Magpie-81/lumenpnp/pnp/pcb/mobo/Mobo_Drawing.pdf

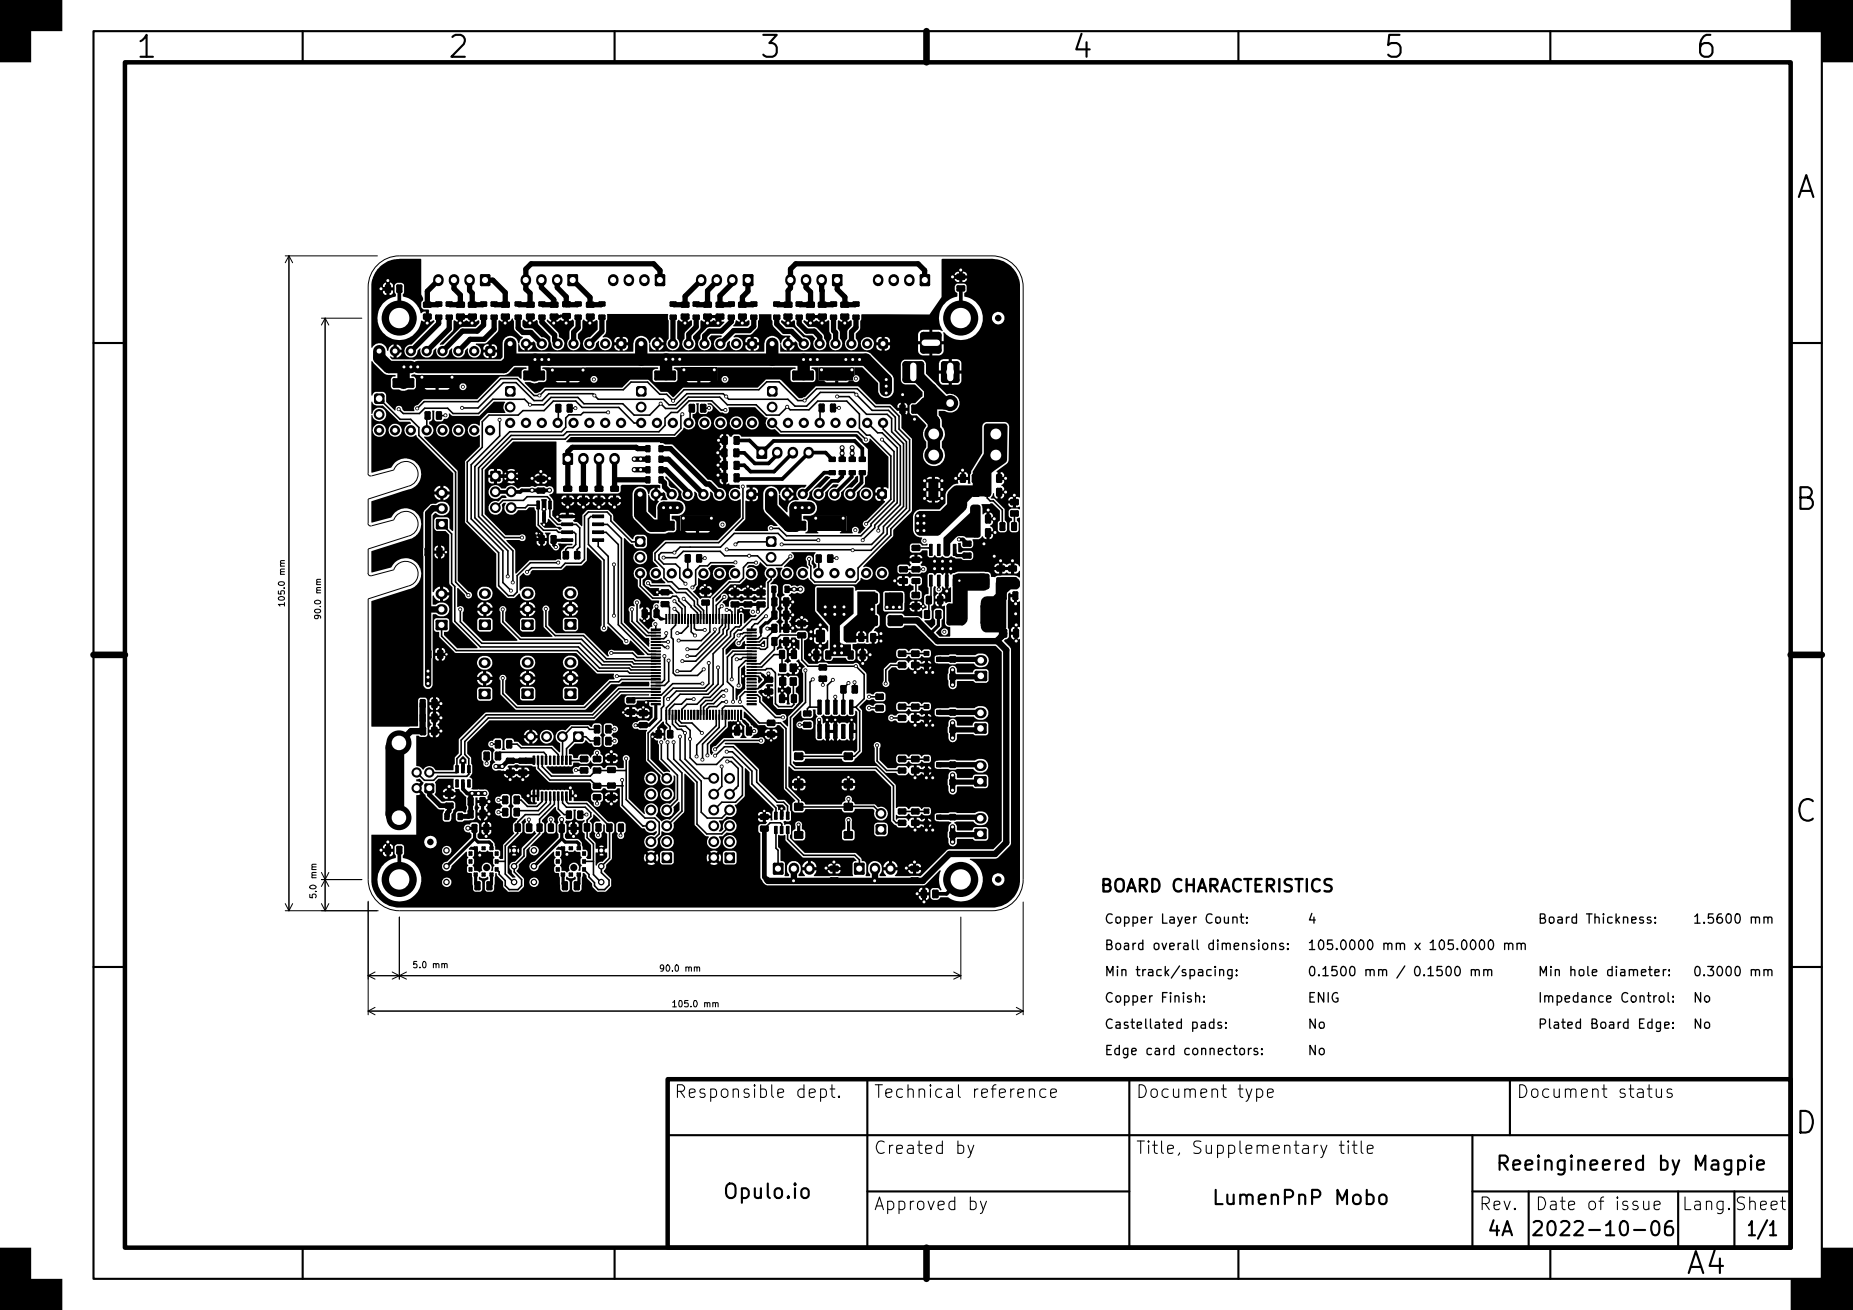
[picture p1: page 1]
