Magpie-81/lumenpnp/pnp/pcb/mobo/RS485.kicad_sch

## KiCad design pnp/pcb/mobo/RS485.kicad_sch (2022-10-09)

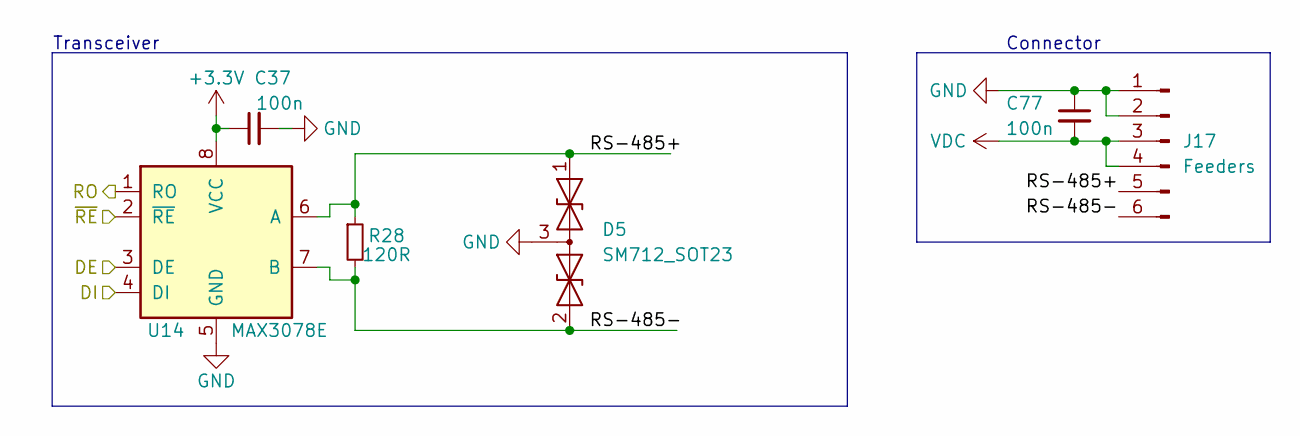
[picture p2: schematic RS485.kicad_sch]

Parts:
C37, C77: 100n; C_0805_2012Metric; Mouser 710-885012207098
D5: SM712_SOT23; SOT-23; Mouser 947-SM712.TCT
J17: Feeders; IDC-Header_2x03_P2.54mm_Vertical; Mouser 538-87834-0619
R28: 120R; R_0805_2012Metric; Mouser 755-SDR10EZPF1200
U14: MAX3078E; SOIC-8_3.9x4.9mm_P1.27mm; Mouser 700-MAX3078EESA

Connections:
+3.3V: C37.1, U14.8 (VCC)
DE: U14.3 (DE)
DI: U14.4 (DI)
GND: C37.2, C77.1, D5.3 (common), J17.1, J17.2, U14.5 (GND)
RO: U14.1 (RO)
RS-485+: D5.1 (A1), J17.5, R28.1, U14.6 (A)
RS-485-: D5.2 (A2), J17.6, R28.2, U14.7 (B)
VDC: C77.2, J17.3, J17.4
~RE: U14.2 (~RE)

Notes on the sheet:
Transceiver
Connector
