Magpie-81/lumenpnp/pnp/pcb/mobo/lighting.kicad_sch

## KiCad design pnp/pcb/mobo/lighting.kicad_sch (2022-10-09)

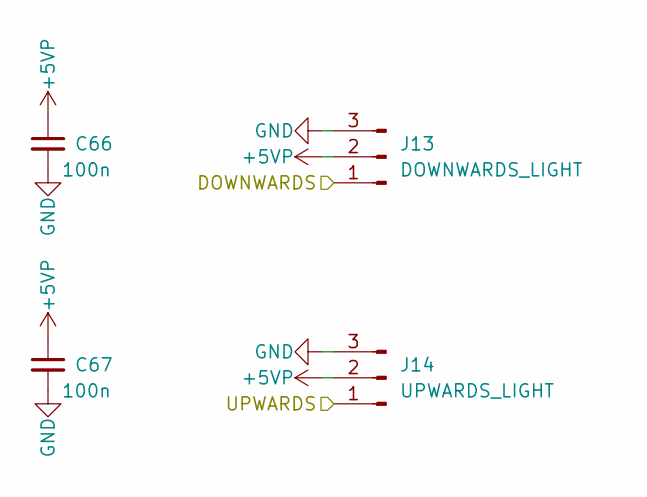
[picture p4: schematic lighting.kicad_sch]

Parts:
C66, C67: 100n; C_0805_2012Metric; Mouser 710-885012207098
J13: DOWNWARDS_LIGHT; JST_XH_B3B-XH-A_1x03_P2.50mm_Vertical; Digikey 455-2248-ND
J14: UPWARDS_LIGHT; JST_XH_B3B-XH-A_1x03_P2.50mm_Vertical; Digikey 455-2248-ND

Connections:
+5VP: C66.1, C67.1, J13.2, J14.2
DOWNWARDS: J13.1
GND: C66.2, C67.2, J13.3, J14.3
UPWARDS: J14.1
