Magpie-81/lumenpnp/pnp/pcb/mobo/microcontroller.kicad_sch

## KiCad design pnp/pcb/mobo/microcontroller.kicad_sch (2022-10-09)

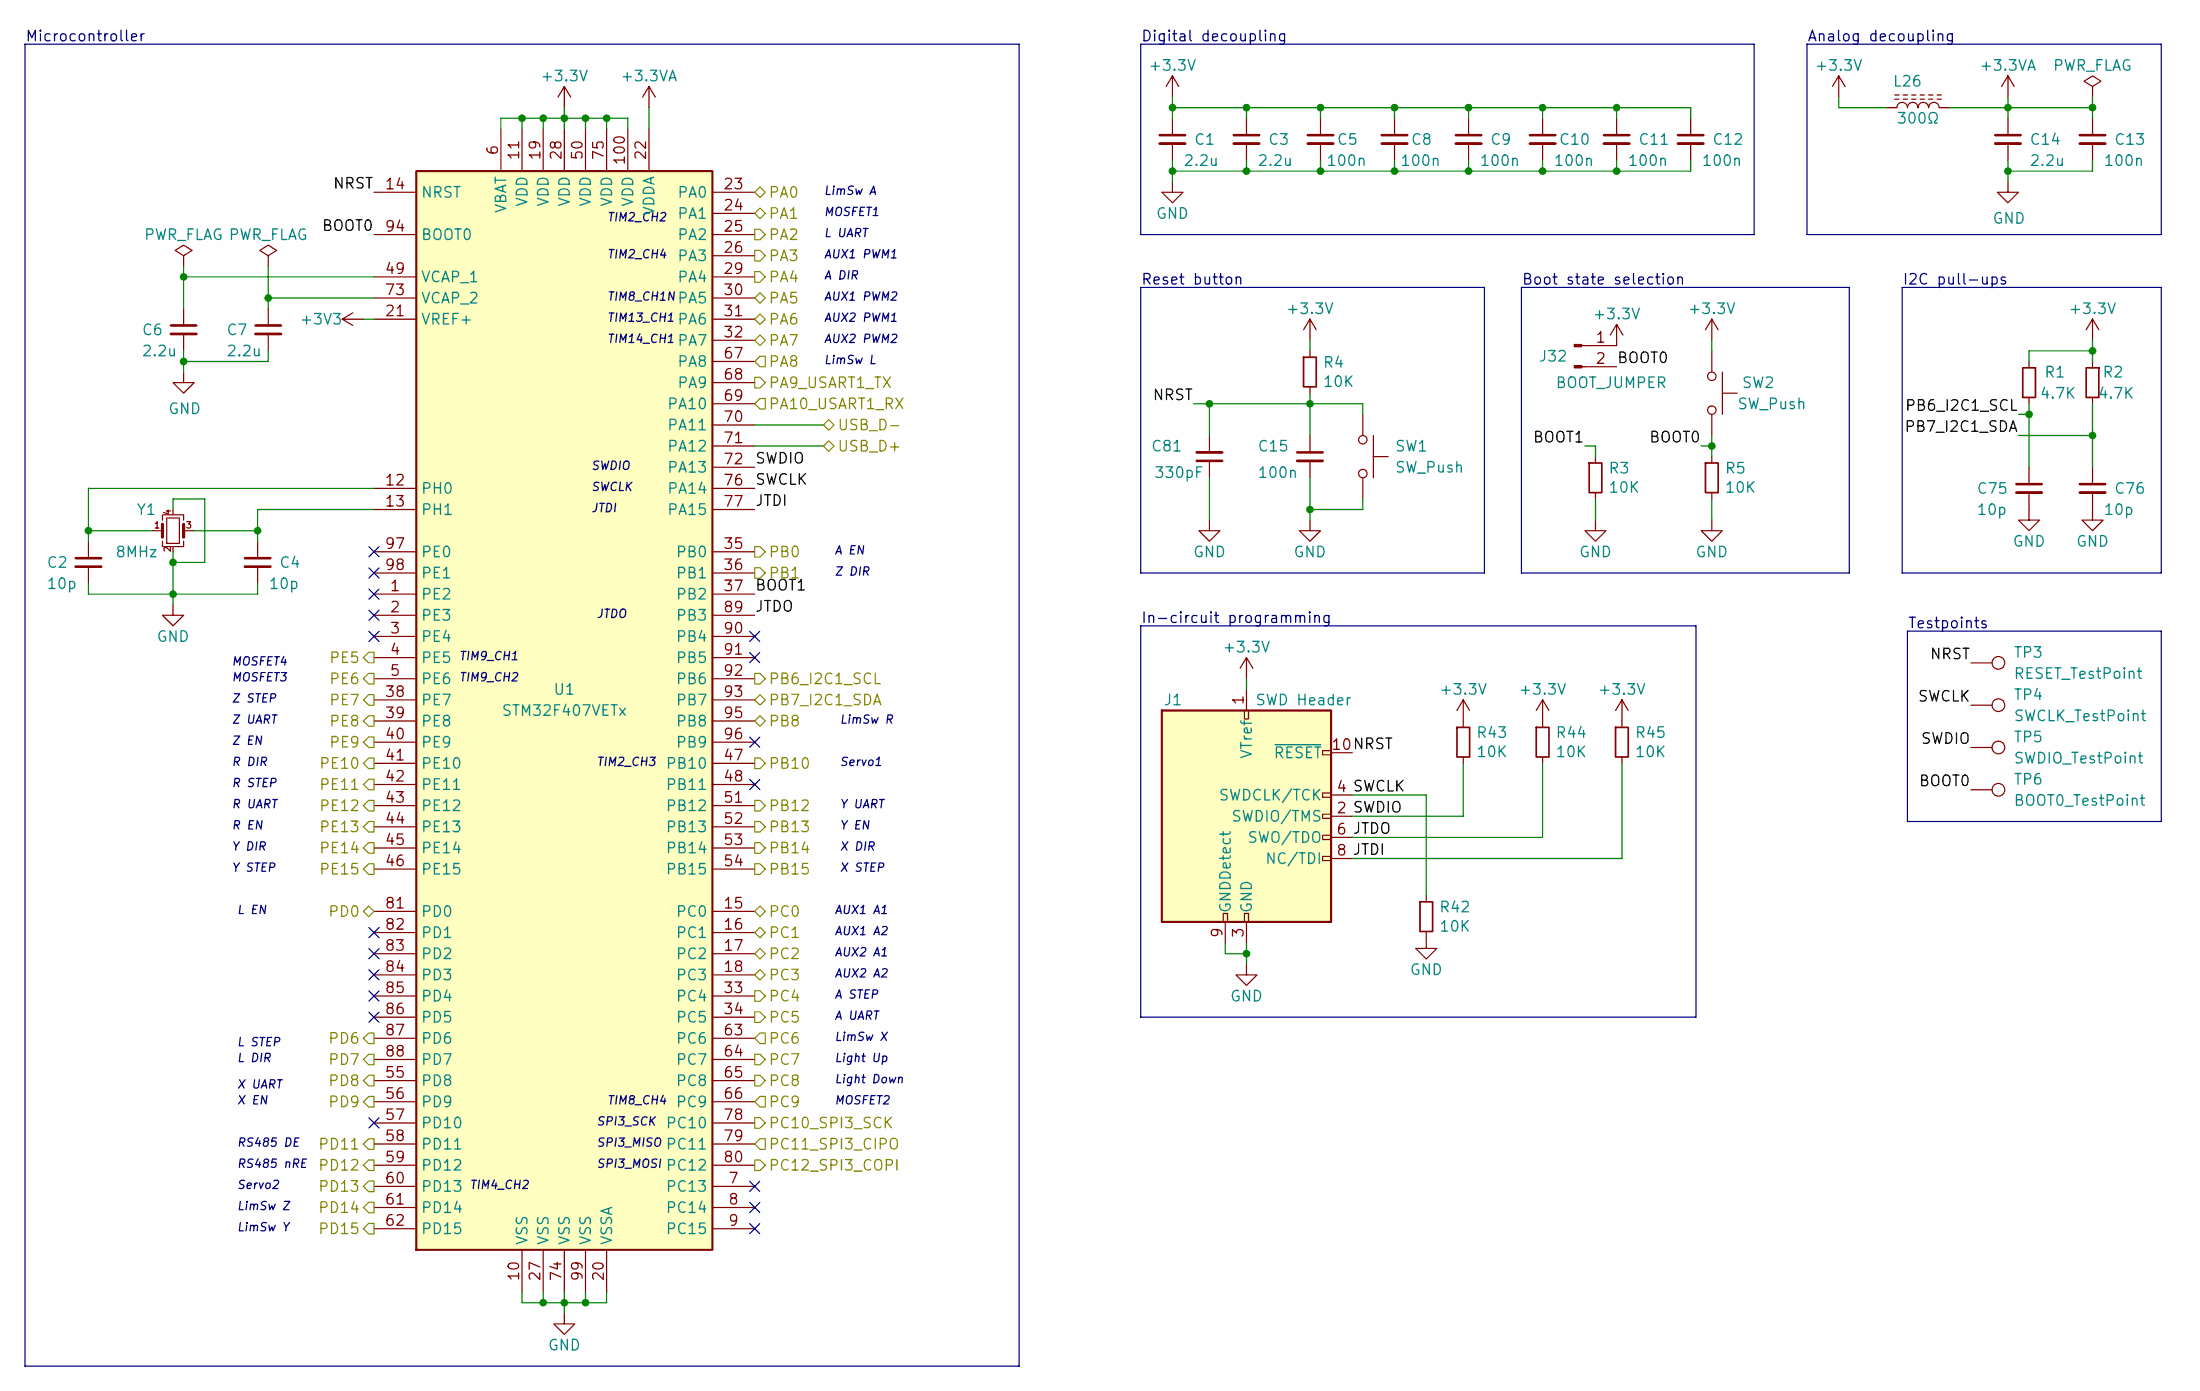
[picture p6: schematic microcontroller.kicad_sch]

Parts:
C1, C3, C6, C7, C14: 2.2u; C_0805_2012Metric; Mouser 810-C2012X5R1H225K
C2, C4, C75, C76: 10p; C_0805_2012Metric; Mouser 603-CC805JRNPO9BN100
C5, C8, C9, C10, C11, C12, C13, C15: 100n; C_0805_2012Metric; Mouser 710-885012207098
C81: 330pF; C_0805_2012Metric; Tolerance 10%; Voltage 50V; Mouser 80-C0805C331K5RAC
J1: SWD Header; PinHeader_2x05_P1.27mm_Vertical_SMD; Mouser 200-FTSH10501FDVKPTR
J32: BOOT_JUMPER; PinHeader_1x02_P2.54mm_Vertical; Mouser 571-5-146280-2
L26: 300Ω; L_0805_2012Metric; Manufacturer PartNumber 742792031; Mouser 710-742792031
R1, R2: 4.7K; R_0805_2012Metric; Mouser 603-RC0805FR-104K7L
R3, R4, R5, R42, R43, R44, R45: 10K; R_0805_2012Metric; Mouser 603-RC0805FR-1010KL
SW1, SW2: SW_Push; SW_SPST_B3S-1000; Mouser 769-EVP-BT1A4A000
TP3: RESET_TestPoint; TestPoint_Pad_D2.0mm
TP4: SWCLK_TestPoint; TestPoint_Pad_D2.0mm
TP5: SWDIO_TestPoint; TestPoint_Pad_D2.0mm
TP6: BOOT0_TestPoint; TestPoint_Pad_D2.0mm
U1: STM32F407VETx; LQFP-100_14x14mm_P0.5mm; Digikey 497-12075-ND
Y1: 8MHz; Crystal_SMD_3225-4Pin_3.2x2.5mm; Digikey 50-ECS-80-10-33-CHN-CT-ND

Connections:
+3.3V: C1.1, C3.1, C5.1, C8.1, C9.1, C10.1, C11.1, C12.1, J1.1 (VTref), J32.1, L26.1, R1.1, R2.1, R4.1, R43.1, R44.1, R45.1, SW2.2, U1.6 (VBAT), U1.11 (VDD), U1.19 (VDD), U1.28 (VDD), U1.50 (VDD), U1.75 (VDD), U1.100 (VDD)
+3.3VA: C13.1, C14.1, L26.2, U1.22 (VDDA)
+3V3: U1.21 (VREF+)
BOOT0: J32.2, R5.1, SW2.1, TP6.1, U1.94 (BOOT0)
BOOT1: R3.1, U1.37 (PB2)
GND: C1.2, C2.2, C3.2, C4.2, C5.2, C6.2, C7.2, C8.2, C9.2, C10.2, C11.2, C12.2, C13.2, C14.2, C15.2, C75.2, C76.2, C81.1, J1.3 (GND), J1.5 (GND), J1.9 (GNDDetect), R3.2, R5.2, R42.2, SW1.1, U1.10 (VSS), U1.20 (VSSA), U1.27 (VSS), U1.74 (VSS), U1.99 (VSS), Y1.2, Y1.4
JTDI: J1.8 (NC/TDI), R45.2, U1.77 (PA15)
JTDO: J1.6 (SWO/TDO), R44.2, U1.89 (PB3)
NRST: C15.1, C81.2, J1.10 (~RESET), R4.2, SW1.2, TP3.1, U1.14 (NRST)
unnamed: C2.1, U1.12 (PH0), Y1.1
unnamed: C4.1, U1.13 (PH1), Y1.3
unnamed: C6.1, U1.49 (VCAP_1)
unnamed: C7.1, U1.73 (VCAP_2)
PA0: U1.23 (PA0)
PA1: U1.24 (PA1)
PA2: U1.25 (PA2)
PA3: U1.26 (PA3)
PA4: U1.29 (PA4)
PA5: U1.30 (PA5)
PA6: U1.31 (PA6)
PA7: U1.32 (PA7)
PA8: U1.67 (PA8)
PA9_USART1_TX: U1.68 (PA9)
PA10_USART1_RX: U1.69 (PA10)
PB0: U1.35 (PB0)
PB1: U1.36 (PB1)
PB6_I2C1_SCL: C75.1, R1.2, U1.92 (PB6)
PB7_I2C1_SDA: C76.1, R2.2, U1.93 (PB7)
PB8: U1.95 (PB8)
PB10: U1.47 (PB10)
PB12: U1.51 (PB12)
PB13: U1.52 (PB13)
PB14: U1.53 (PB14)
PB15: U1.54 (PB15)
PC0: U1.15 (PC0)
PC1: U1.16 (PC1)
PC2: U1.17 (PC2)
PC3: U1.18 (PC3)
PC4: U1.33 (PC4)
PC5: U1.34 (PC5)
PC6: U1.63 (PC6)
PC7: U1.64 (PC7)
PC8: U1.65 (PC8)
PC9: U1.66 (PC9)
PC10_SPI3_SCK: U1.78 (PC10)
PC11_SPI3_CIPO: U1.79 (PC11)
PC12_SPI3_COPI: U1.80 (PC12)
PD0: U1.81 (PD0)
PD6: U1.87 (PD6)
PD7: U1.88 (PD7)
PD8: U1.55 (PD8)
PD9: U1.56 (PD9)
PD11: U1.58 (PD11)
PD12: U1.59 (PD12)
PD13: U1.60 (PD13)
PD14: U1.61 (PD14)
PD15: U1.62 (PD15)
PE5: U1.4 (PE5)
PE6: U1.5 (PE6)
PE7: U1.38 (PE7)
PE8: U1.39 (PE8)
PE9: U1.40 (PE9)
PE10: U1.41 (PE10)
PE11: U1.42 (PE11)
PE12: U1.43 (PE12)
PE13: U1.44 (PE13)
PE14: U1.45 (PE14)
PE15: U1.46 (PE15)
SWCLK: J1.4 (SWDCLK/TCK), R42.1, TP4.1, U1.76 (PA14)
SWDIO: J1.2 (SWDIO/TMS), R43.2, TP5.1, U1.72 (PA13)
USB_D+: U1.71 (PA12)
USB_D-: U1.70 (PA11)

Notes on the sheet:
R EN
LimSw L
Analog decoupling
SWDIO
Light Up
Reset button
X EN
X UART
TIM9_CH2
Y DIR
TIM2_CH3
Microcontroller
TIM8_CH1N
AUX2 PWM1
Servo1
Boot state selection
Digital decoupling
L UART
AUX1 A1
Z STEP
SPI3_SCK
MOSFET4
RS485 nRE
AUX1 PWM2
X STEP
JTDO
LimSw R
TIM14_CH1
Z DIR
Z EN
LimSw X
L EN
A UART
Light Down
AUX2 A1
SPI3_MISO
Y UART
L STEP
TIM8_CH4
R UART
TIM9_CH1
AUX2 PWM2
RS485 DE
R DIR
TIM2_CH2
TIM2_CH4
Y STEP
LimSw A
Servo2
MOSFET2
MOSFET3
AUX1 PWM1
X DIR
A STEP
A DIR
R STEP
Z UART
LimSw Z
Testpoints
TIM4_CH2
In-circuit programming
L DIR
SPI3_MOSI
MOSFET1
AUX2 A2
Y EN
SWCLK
I2C pull-ups
JTDI
AUX1 A2
LimSw Y
A EN
TIM13_CH1
