Magpie-81/lumenpnp/pnp/pcb/mobo/miscellaneous.kicad_sch

## KiCad design pnp/pcb/mobo/miscellaneous.kicad_sch (2022-10-09)

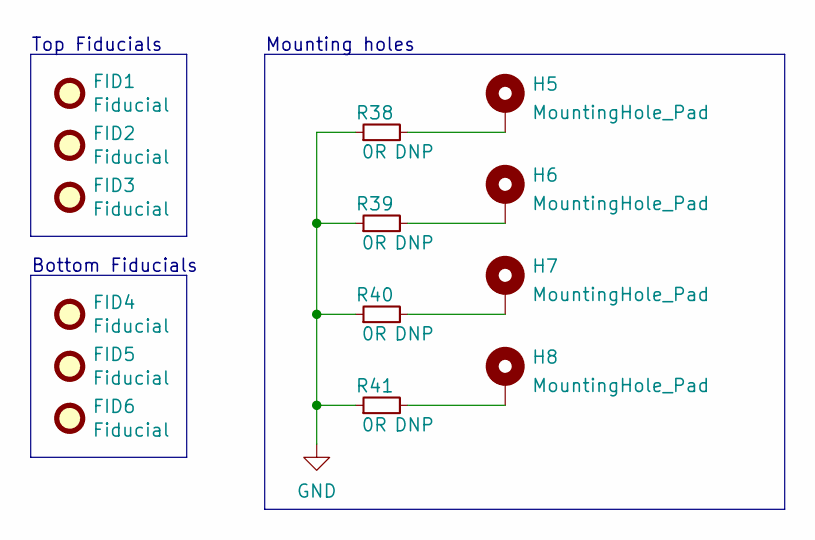
[picture p7: schematic miscellaneous.kicad_sch]

Parts:
FID1, FID2, FID3, FID4, FID5, FID6: Fiducial; Fiducial_1mm_Mask2mm
H5, H6, H7, H8: MountingHole_Pad; MountingHole_3.2mm_M3_DIN965_Pad
R38, R39, R40, R41: 0R; R_0805_2012Metric; Mouser 71-CRCW08050000Z0EAC

Connections:
GND: R38.1, R39.1, R40.1, R41.1
unnamed: H5.1, R38.2
unnamed: H6.1, R39.2
unnamed: H7.1, R40.2
unnamed: H8.1, R41.2

Notes on the sheet:
Bottom Fiducials
Top Fiducials
Mounting holes
