Magpie-81/lumenpnp/pnp/pcb/mobo/mosfet.kicad_sch

## KiCad design pnp/pcb/mobo/mosfet.kicad_sch (2022-10-09)

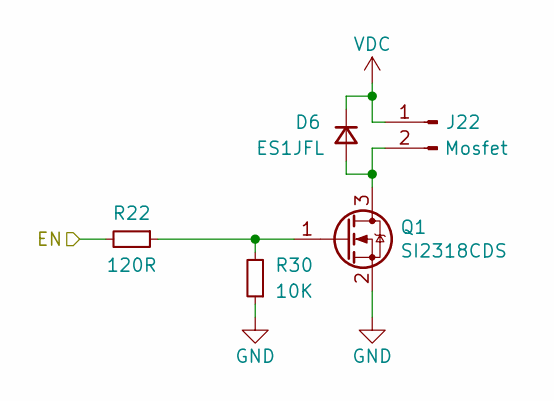
[picture p8: schematic mosfet.kicad_sch]

Parts:
D6: ES1JFL; D_SOD-123F; Mouser 512-ES1JFL
J22: Mosfet; JST_XH_B2B-XH-A_1x02_P2.50mm_Vertical; Digikey 455-2247-ND
Q1: SI2318CDS; SOT-23; Mouser 78-SI2318CDS-T1-BE3
R22: 120R; R_0805_2012Metric; Mouser 755-SDR10EZPF1200
R30: 10K; R_0805_2012Metric; Mouser 603-RC0805FR-1010KL

Connections:
EN: R22.2
GND: Q1.2 (S), R30.1
unnamed: D6.2 (A), J22.2, Q1.3 (D)
unnamed: Q1.1 (G), R22.1, R30.2
VDC: D6.1 (K), J22.1
