Magpie-81/lumenpnp/pnp/pcb/mobo/power.kicad_sch

## KiCad design pnp/pcb/mobo/power.kicad_sch (2022-10-09)

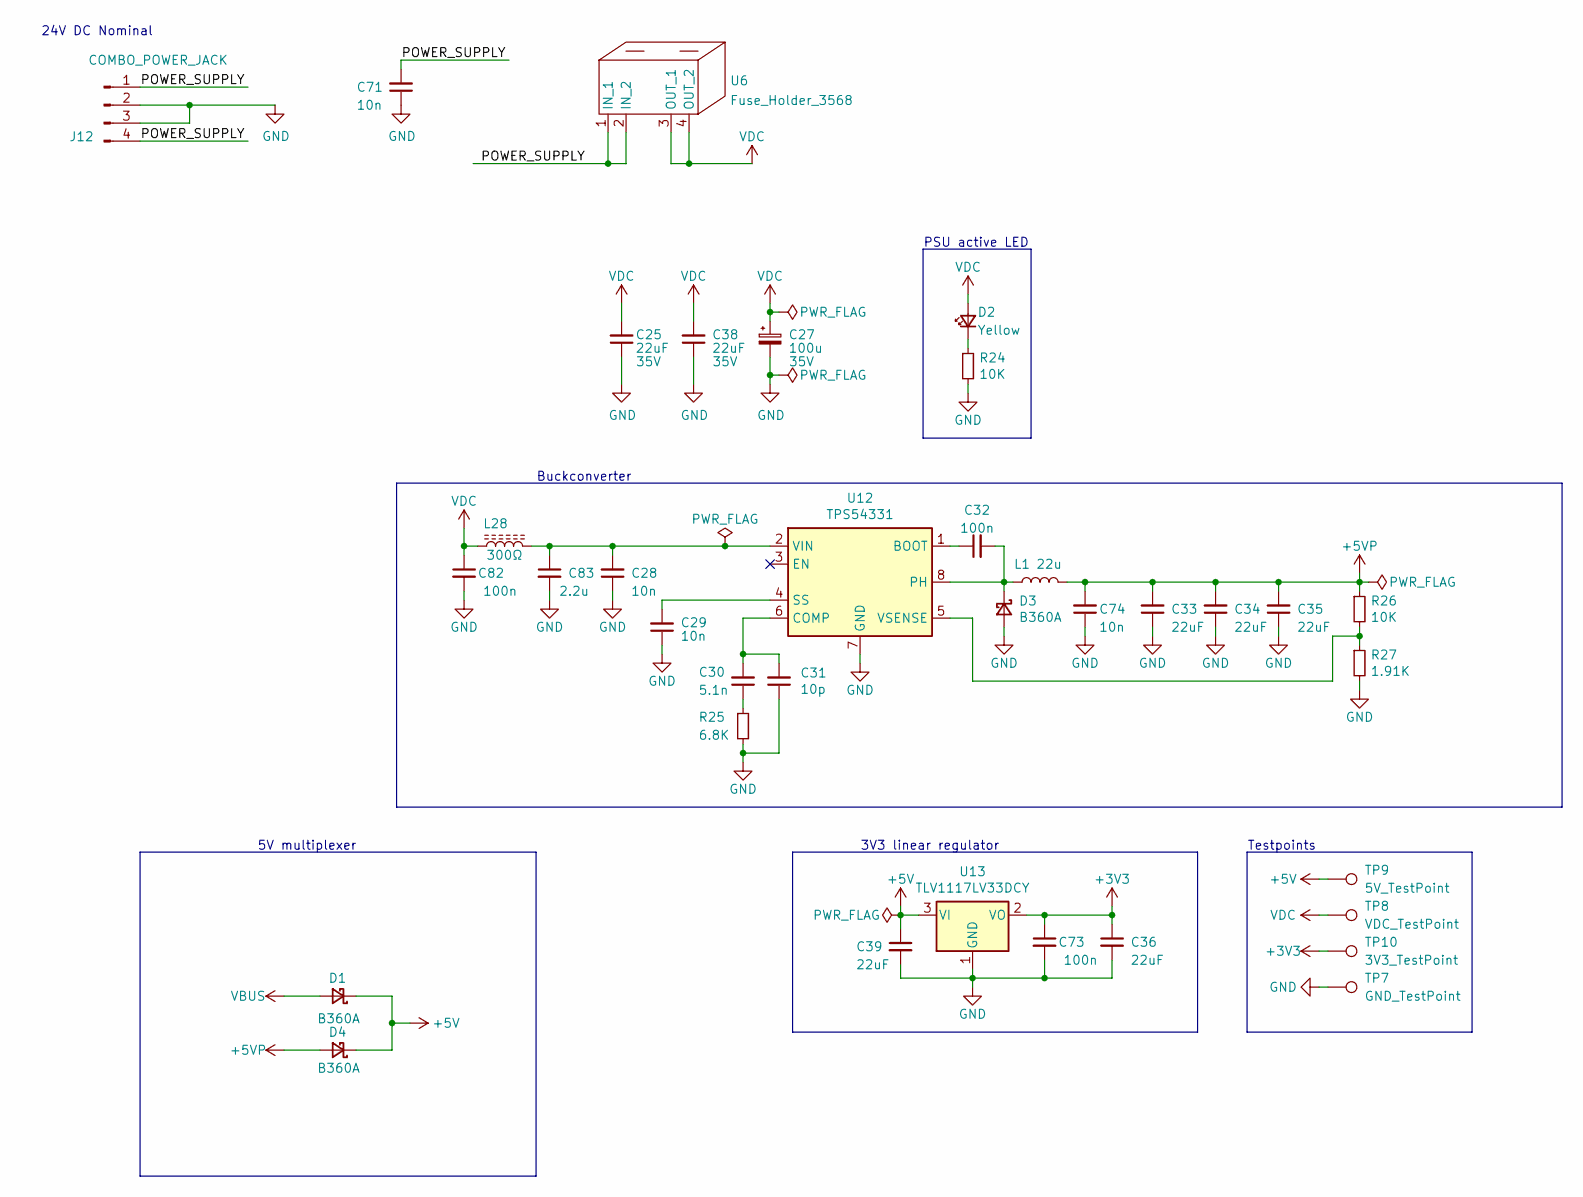
[picture p9: schematic power.kicad_sch]

Parts:
C25, C38: 22uF; C_0805_2012Metric; Voltage 35V; Mouser 810-C2012X5R1V226MAC
C27: 100u; CP_Elec_6.3x7.7; Voltage 35V; Mouser 710-865080545012
C28, C29, C71, C74: 10n; C_0805_2012Metric; Digikey 1276-1015-1-ND
C30: 5.1n; C_0805_2012Metric; Mouser 81-GRM2195C1H512JA1D
C31: 10p; C_0805_2012Metric; Mouser 603-CC805JRNPO9BN100
C32, C73, C82: 100n; C_0805_2012Metric; Mouser 710-885012207098
C33, C34, C35, C36, C39: 22uF; C_0805_2012Metric; Mouser 81-GRM21BR61E226ME4K
C83: 2.2u; C_0805_2012Metric; Mouser 810-C2012X5R1H225K
D1, D3, D4: B360A; D_SMA; Mouser 625-B360A-E3/61T
D2: Yellow; LED_0805_2012Metric; Digikey 732-4987-1-ND
J12: COMBO_POWER_JACK; BarrelJack_Horizontal; Mouser 710-694106301002
L1: 22u; L_Bourns_SRP7028A_7.3x6.6mm; Mouser 652-SRP7028C-220M
L28: 300Ω; L_0805_2012Metric; Manufacturer PartNumber 742792031; Mouser 710-742792031
R24, R26: 10K; R_0805_2012Metric; Mouser 603-RC0805FR-1010KL
R25: 6.8K; R_0805_2012Metric; Mouser 603-RT0603FRE076K8L
R27: 1.91K; R_0805_2012Metric; Mouser 71-CRCW08051K91FKEA
TP7: GND_TestPoint; TestPoint_Pad_D2.0mm
TP8: VDC_TestPoint; TestPoint_Pad_D2.0mm
TP9: 5V_TestPoint; TestPoint_Pad_D2.0mm
TP10: 3V3_TestPoint; TestPoint_Pad_D2.0mm
U6: Fuse_Holder_3568; Mouser 534-3568
U12: TPS54331; SOIC-8_3.9x4.9mm_P1.27mm; Digikey 296-26991-1-ND
U13: TLV1117LV33DCY; SOT-223-3_TabPin2; Digikey 296-35976-1-ND

Connections:
+3V3: C36.1, C73.1, TP10.1, U13.2 (VO)
+5V: C39.1, D1.1 (K), D4.1 (K), TP9.1, U13.3 (VI)
+5VP: C33.2, C34.2, C35.2, C74.2, D4.2 (A), L1.2, R26.1
GND: C25.1, C27.2, C28.1, C29.1, C31.1, C33.1, C34.1, C35.1, C36.2, C38.1, C39.2, C71.1, C73.2, C74.1, C82.2, C83.2, D3.2 (A), J12.2, J12.3, R24.2, R25.2, R27.2, TP7.1, U12.7 (GND), U13.1 (GND)
unnamed: C28.2, C83.1, L28.2, U12.2 (VIN)
unnamed: C29.2, U12.4 (SS)
unnamed: C30.1, R25.1
unnamed: C30.2, C31.2, U12.6 (COMP)
unnamed: C32.1, U12.1 (BOOT)
unnamed: C32.2, D3.1 (K), L1.1, U12.8 (PH)
unnamed: D2.1 (K), R24.1
unnamed: R26.2, R27.1, U12.5 (VSENSE)
POWER_SUPPLY: C71.2, J12.1, J12.4, U6.1 (IN_1), U6.2 (IN_2)
VBUS: D1.2 (A)
VDC: C25.2, C27.1, C38.2, C82.1, D2.2 (A), L28.1, TP8.1, U6.3 (OUT_1), U6.4 (OUT_2)

Notes on the sheet:
Buckconverter
Testpoints
PSU active LED
3V3 linear regulator
5V multiplexer
24V DC Nominal
