Magpie-81/lumenpnp/pnp/pcb/mobo/servos.kicad_sch

## KiCad design pnp/pcb/mobo/servos.kicad_sch (2022-10-09)

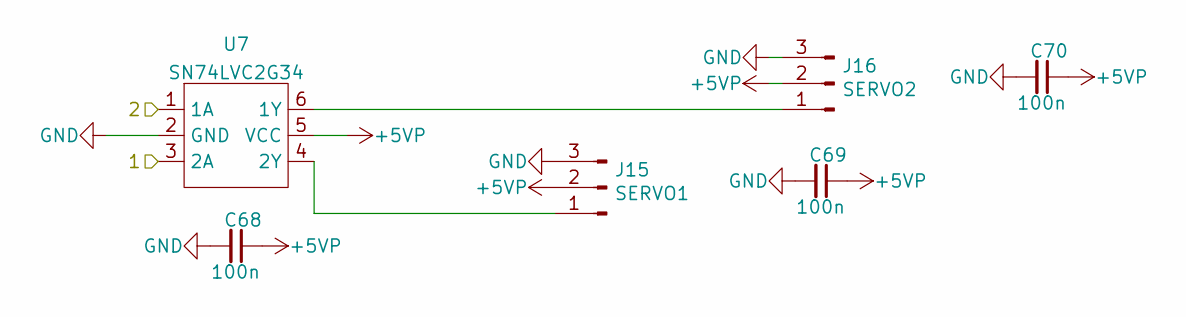
[picture p10: schematic servos.kicad_sch]

Parts:
C68, C69, C70: 100n; C_0805_2012Metric; Mouser 710-885012207098
J15: SERVO1; JST_XH_B3B-XH-A_1x03_P2.50mm_Vertical; Digikey 455-2248-ND
J16: SERVO2; JST_XH_B3B-XH-A_1x03_P2.50mm_Vertical; Digikey 455-2248-ND
U7: SN74LVC2G34; SOT-23-6; Mouser 595-SN74LVC2G34DBVR

Connections:
1: U7.3 (2A)
2: U7.1 (1A)
+5VP: C68.1, C69.1, C70.1, J15.2, J16.2, U7.5 (VCC)
GND: C68.2, C69.2, C70.2, J15.3, J16.3, U7.2 (GND)
unnamed: J15.1, U7.4 (2Y)
unnamed: J16.1, U7.6 (1Y)
