Magpie-81/lumenpnp/pnp/pcb/mobo/usb.kicad_sch

## KiCad design pnp/pcb/mobo/usb.kicad_sch (2022-10-09)

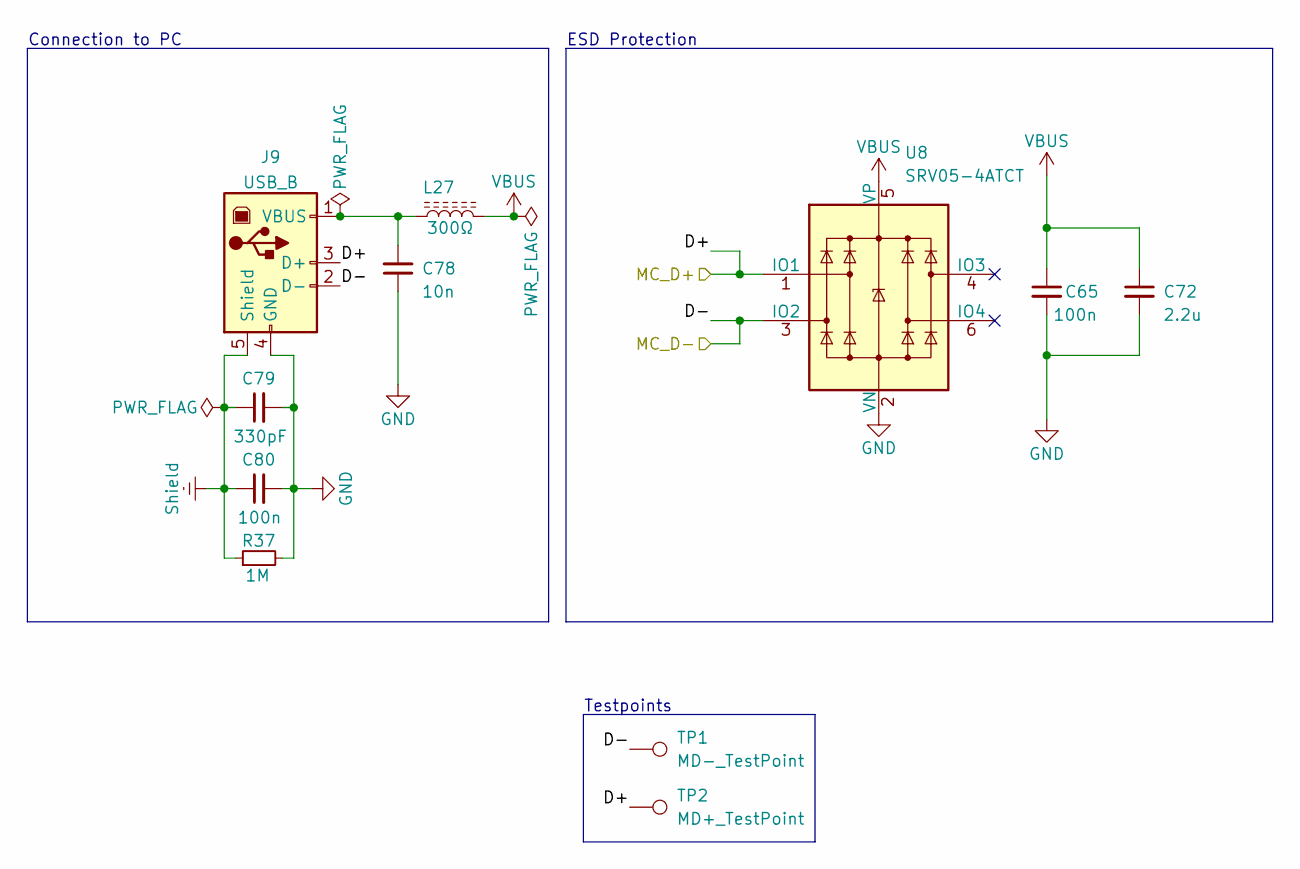
[picture p12: schematic usb.kicad_sch]

Parts:
C65, C80: 100n; C_0805_2012Metric; Mouser 710-885012207098
C72: 2.2u; C_0805_2012Metric; Mouser 810-C2012X5R1H225K
C78: 10n; C_0805_2012Metric; Digikey 1276-1015-1-ND
C79: 330pF; C_0805_2012Metric; Tolerance 10%; Voltage 50V; Mouser 80-C0805C331K5RAC
J9: USB_B; USB_B_Lumberg_2411_02_Horizontal; Mouser 710-61400416121
L27: 300Ω; L_0805_2012Metric; Manufacturer PartNumber 742792031; Mouser 710-742792031
R37: 1M; R_0805_2012Metric; Mouser 71-CRCW08051M00FKEAC
TP1: MD-_TestPoint; TestPoint_Pad_D2.0mm
TP2: MD+_TestPoint; TestPoint_Pad_D2.0mm
U8: SRV05-4ATCT; SOT-23-6; Mouser 947-SRV05-4ATCT

Connections:
D+: J9.3 (D+), TP2.1, U8.1 (IO1)
D-: J9.2 (D-), TP1.1, U8.3 (IO2)
Earth: C79.1, C80.1, J9.5 (Shield), R37.1
GND: C65.2, C72.2, C78.1, C79.2, C80.2, J9.4 (GND), R37.2, U8.2 (VN)
unnamed: C78.2, J9.1 (VBUS), L27.1
VBUS: C65.1, C72.1, L27.2, U8.5 (VP)

Notes on the sheet:
ESD Protection
Testpoints
Connection to PC
