Magpie-81/lumenpnp/pnp/pcb/mobo/vacuum_sensors.kicad_sch

## KiCad design pnp/pcb/mobo/vacuum_sensors.kicad_sch (2022-10-09)

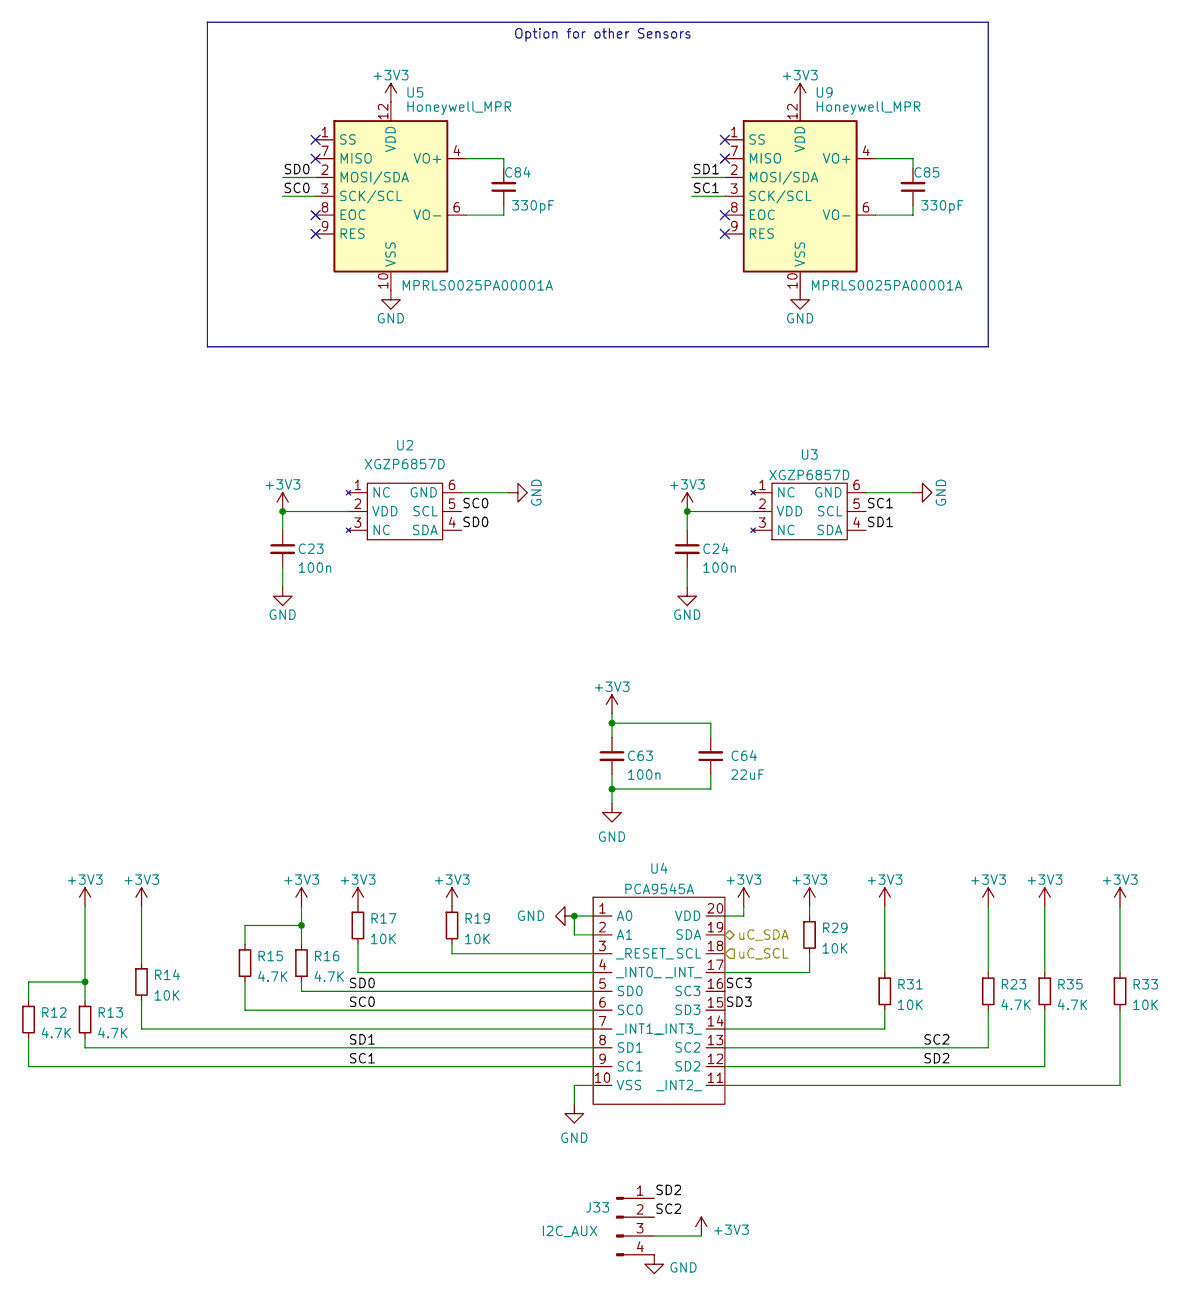
[picture p13: schematic vacuum_sensors.kicad_sch]

Parts:
C23, C24, C63: 100n; C_0805_2012Metric; Mouser 710-885012207098
C64: 22uF; C_0805_2012Metric; Mouser 81-GRM21BR61E226ME4K
C84, C85: 330pF; C_0805_2012Metric; Tolerance 10%; Voltage 50V; Mouser 80-C0805C331K5RAC
J33: I2C_AUX; PinHeader_1x04_P2.54mm_Vertical; Mouser 571-5-146277-4
R12, R13, R15, R16, R23, R35: 4.7K; R_0805_2012Metric; Mouser 603-RC0805FR-104K7L
R14, R17, R19, R29, R31, R33: 10K; R_0805_2012Metric; Mouser 603-RC0805FR-1010KL
U2, U3: XGZP6857D
U4: PCA9545A; TSSOP-20_4.4x6.5mm_P0.65mm; Mouser 771-PCA9545APW-T
U5, U9: Honeywell_MPR; Honeywell_MPR_5x5mm_LGA12; Part_Nbr MPRLS0025PA00001A; Mouser 785-MPRLS0025PA00001

Connections:
+3V3: C23.1, C24.1, C63.1, C64.2, J33.3, R12.1, R13.1, R14.1, R15.1, R16.1, R17.1, R19.1, R23.1, R29.1, R31.1, R33.1, R35.1, U2.2 (VDD), U3.2 (VDD), U4.20 (VDD), U5.12 (VDD), U9.12 (VDD)
GND: C23.2, C24.2, C63.2, C64.1, J33.4, U2.6 (GND), U3.6 (GND), U4.1 (A0), U4.2 (A1), U4.10 (VSS), U5.10 (VSS), U9.10 (VSS)
unnamed: C84.1, U5.6 (VO-)
unnamed: C84.2, U5.4 (VO+)
unnamed: C85.1, U9.6 (VO-)
unnamed: C85.2, U9.4 (VO+)
unnamed: R14.2, U4.7 (_INT1_)
unnamed: R17.2, U4.4 (_INT0_)
unnamed: R19.2, U4.3 (_RESET_)
unnamed: R29.2, U4.17 (_INT_)
unnamed: R31.2, U4.14 (_INT3_)
unnamed: R33.2, U4.11 (_INT2_)
unnamed: U5.5 (NC), U5.11 (NC)
unnamed: U9.5 (NC), U9.11 (NC)
SC0: R15.2, U2.5 (SCL), U4.6 (SC0), U5.3 (SCK/SCL)
SC1: R12.2, U3.5 (SCL), U4.9 (SC1), U9.3 (SCK/SCL)
SC2: J33.2, R23.2, U4.13 (SC2)
SC3: U4.16 (SC3)
SD0: R16.2, U2.4 (SDA), U4.5 (SD0), U5.2 (MOSI/SDA)
SD1: R13.2, U3.4 (SDA), U4.8 (SD1), U9.2 (MOSI/SDA)
SD2: J33.1, R35.2, U4.12 (SD2)
SD3: U4.15 (SD3)
uC_SCL: U4.18 (SCL)
uC_SDA: U4.19 (SDA)

Notes on the sheet:
Option for other Sensors
