Magpie-81/lumenpnp/(commit log)

2022-09-11 Mobo V4A Redesign
    Some EMC improvements to schematics.
    Reassigned MCU Pins for HW-PWM support.
    Changes are still marked with text in the schematics.
    Complete PCB Layout reworked
    Status: Needs to be verified, and cleaned up a little, but DRC is running green.
    [RS485.kicad_sch, aux_header.kicad_sch, aux_headers.kicad_sch, dual_motors.kicad_sch, lighting.kicad_sch, limit_switches.kicad_sch, microcontroller.kicad_sch, miscellaneous.kicad_sch]
2022-10-09 Redesign finished
    Completed Board redesign and adding more EMC improvements.
    Changed all the part numbers to have a Mouser orderable design (except the JST connectors)
    All outputs generated
    [ChangeLog.kicad_sch, RS485.kicad_sch, aux_header.kicad_sch, aux_headers.kicad_sch, dual_motors.kicad_sch, lighting.kicad_sch, limit_switches.kicad_sch, microcontroller.kicad_sch]
